GDH-Technologies/cx-clockgen/README.md

# cx-clockgen
Essentially a fork of Rene Wolf's `cxadc-clock-generator-audio-adc` gitlab project
