GDH-Technologies/cx-clockgen/kicad-cx-jig/render-rev-b.png

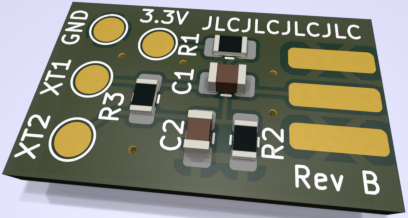
kicad-cx-jig/render-rev-b.png
