GDH-Technologies/cx-clockgen/build-guide/README.md

# Build and installation guide

Ahh so you've come here to build the project, *excellent*!

Before you start ordering and building, you should read the entire guide at least once so you know what to expect.
You will be assembling the project from various ready made components and solder them together.
Most components can be ordered in a finished and populated state, basically you only need to wire them up.
But the two main PCBs of this project need to be ordered with either [JLCPCB][jlcpcb] or [PcbWay][pcbway] and then some SMD parts populated manually.
Don't worry though all SMD parts are rather large 0805, and ordering them with [JLCPCB][jlcpcb] is fast and cheap!
The [hardware](../hardware) section of this project includes the full [KiCad][kicad] project files, so you can also generate gerbers for a different manufacturing house.

If you are new to soldering electronics, learning about it is a bit beyond this guide.
However you may want to start looking here, as these videos cover the things needed for this guide:
- Branchus Creations Beginner's Guide to Soldering Electronics [Part 1](https://www.youtube.com/watch?v=M2Jf8cebwCs) and [Part 2](https://www.youtube.com/watch?v=BPuH1Z2npoQ)
- Electronoobs [SMD Soldering Tutorial | Guide | Tools | Tecniques | Stencil](https://www.youtube.com/watch?v=fYInlAmPnGo)

The steps covered here will assemble the electronic components and flash the firmware on the Raspberry Pi Pico.
Mounting the finished build in your particular PC / setup is beyond the scope of this guide.
You can however have a look in the [mechanical section](../mechanical) for some 3D printable parts that may suit your needs.

This guide will assume you have two PCIe CX based capture cards ready to be modded.
Have a look [over here][vhs-decode-wiki-cxcard] for some sources and options on acquiring those cards.
The instruction in here possibly work with other models, but they were tested and confirmed working with these variants:
- *VT610EX Rev:SC3A VTImage 19.07* capture cards, white pcb, featuring a *CX25800-11Z*

If your board / card variant is not listed here, go over the guide and compare the instructions to your card.
If the parts they are referring to also exist on your board, there's a good chance this guide also works for you.

## General prerequisites

You will be dealing with high frequency digital clock signals.
Even though these are more immune to problems than analog signals, you should have a [Digital storage oscilloscope][wiki-dso] at hand.
You can assemble all of this project without one, but you probably want to check signal integrity, before putting everything together.
In order to correctly assess the signals, your scope should have an analog bandwidth of at least 20MHz, better 100MHz.

You should also have a [Multimeter](https://en.wikipedia.org/wiki/Multimeter#Digital) ready, to test continuity, and verify resistance and possibly capacity.

And finally you will need some basic soldering equipment. 
A fine tip (e.g. 1mm) soldering iron and some good lead-free solder.

Each of the PCBs has a shopping list of components you need to order.
For the SMD parts I always order some spares, in case I make a mistake.
So put add something like 10% additional parts, but at least one extra component per type.

## Ordering PCBs

If you choose a manufacturing house other than [JLCPCB][jlcpcb] or [PcbWay][pcbway], you already know what you need.
The [releases section][releases] of this project holds the finished gerbers for ordering directly from [JLCPCB][jlcpcb] or [PcbWay][pcbway].
When ordering from [JLCPCB][jlcpcb], you should check [these settings (valid as of Sep. 2023)](../hardware/jlc-2023-09-order-example.png) for both boards.
When ordering from [PcbWay][pcbway], you should check [these settings (valid as of Nov. 2023)](../hardware/pcbway-2023-11-order-example.png) for both boards.
The minimum quantity (as of Nov. 2023) is 5 per PCBs (on both manufacturing houses), so for a single clock gen with two [CXADC][cxadc] cards, you will have some spares.

## Building PCB 1 - VT610ex clock generator insert

This PCB adapter will replace the quartz oscillator on a VT610ex PICe capture card.
So you will need to build one these PCBs / adapters per [CXADC][cxadc] card you have.

render

**Shopping list** for *one single* adapter (multiply items by number cards you want to modify):
- 1x PCB "clock-gen-adapter" probably from [JLCPCB][jlcpcb]
- 2x 0805 SMD resistor 1K Ohm, 5% tolerance or better
- 1x 0805 SMD resistor 10K Ohm, 5% tolerance or better
- 1x 0805 SMD capacitor 1.5 nF, 6V or greater, ceramic X5R or X7R
- 1x 0805 SMD capacitor 10 nF, 6V or greater, ceramic X5R or X7R
- Thin wire in 4 colors, AWG 30 (0.25mm) to AWG 20 (0.81mm) works well
- The PCB supports two options for connection to the mainboard
  - Either with pin header / socket and a custom made coax cable
    - 1x 3x2.54mm pin header, straight (it will be mounted "lying / sideways" on the PCB)
    - 1x 3x2.54mm pin socket, straight (it will be soldered as a connector to the coax cable)
    - About 50cm of RG174 coax cable.
      This will be used to connect the adapter to the clock gen mainboard, and the exact length depends on your installation situation.
      You can use a different type of cable here, but the RG174 is still flexible enough to be convenient to handle.
    - Some heat-shrink tube to cover the coax and pin socket
    - Double sided tape to attach the adapter PCB to the back of the CX card
  - Or via SMA edge connectors, which should be paired with another one on the Si5351A sub board
    - 2x Female edge mounting SMA connectors (one for the adapter, and one for the mainboard / Si5351A sub board).
      There are a number of manufacturers that produce these, but they should be about 6-7mm side-to-side, and have a 1.6-1.8 mm PCB clearance, e.g [CON-SMA-EDGE-S](https://mou.sr/3t0dMKq)
    - 1x Male to male SMA cable with a length matching your installation requirements, e.g. [250mm 135101-03-M0.25](https://mou.sr/3Tggbf5)
    - Thick double sided tape to attach the adapter PCB to the back of the CX card.
      Thickness must give enough clearance for the edge mounting SMA connectors, about 2mm should be fine.

First populate the SMD components on the PCB like so:
- R1, R2 as 1K Ohm
- R3 10K Ohm
- C1 1.5 nF
- C2 10 nF

Then solder the 3x pin header sideways onto the edge of the PCB, or solder the edge mounting SMA connector.
Finally solder about 10 cm (4 inches) of wire to each of the pads (XT1, XT2, GND, 3.3V).
Use different colors per pad for easier installation.
You should end up with something like this (pin header shown, not SMA edge connector):

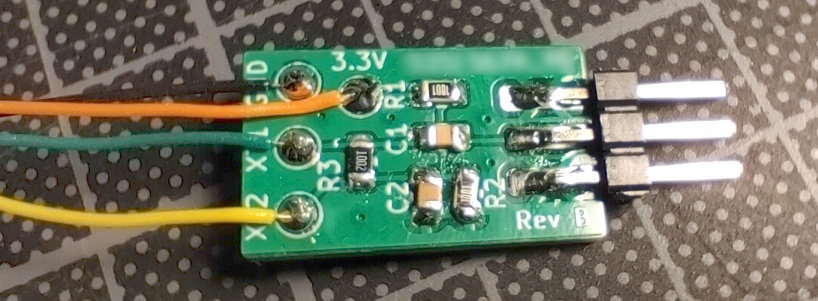
[picture p2: build-guide/adapter-revb-populated.jpg]


If you chose the SMA connector option, this completes the adapter board.

Otherwise you now need to finish the coax cable and connection.
So take the desired length of RG174 coax cable and solder the 3x pin socket to one end.
Remember you can always shorten the cable later, so add some extra length here.
The center pin is the clock signal, the other two pins are shield / ground.
Finally with some heat shrink over it, you should end up with something like this:

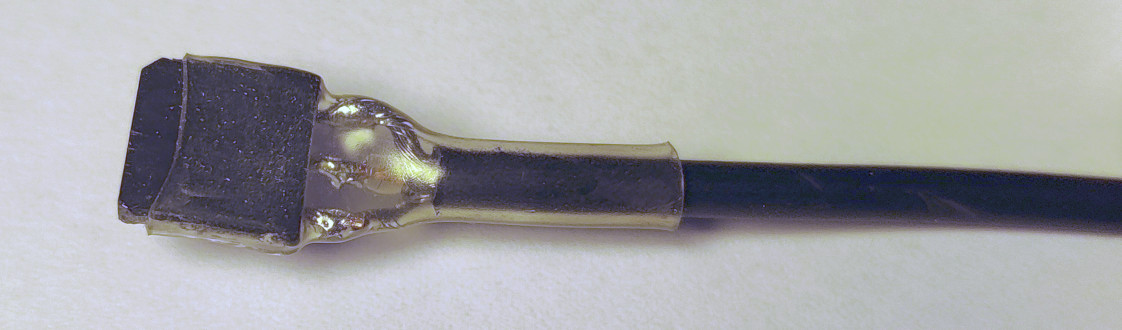
[picture p3: build-guide/adapter-coax-plug.jpg]


This completes the adapter board, so it can be later mounted to a CX card.

## Building PCB 2 - Clock generator and ADC mainboard

This PCB combines a [Raspberry Pi Pico][pi-pico] with a [Adafruit Si5351A Clock Generator Breakout Board][si5351-adafruit], and a [PCM1802 board][pcm1802-product].
The clock generator produces 3 clocks, clock 0 and clock 1 are available for two [CXADC][cxadc] cards, clock 2 drives the [PCM1802 ADC][pcm1802-product].
Optionally a digital input pin can sample the *head switch signal* from your VCR, or any other sync signal you choose.

render

The various sub components can be soldered / mounted on the mainboard, with only pin headers as connection.
However adding pin sockets will enable easy component swapping later, and greatly help with troubleshooting!

**Shopping list mandatory components only** for one mainboard:
- 1x PCB "clock-gen mainboard" probably from [JLCPCB][jlcpcb]
- 1x [Raspberry Pi Pico][pi-pico] (wireless variant can be used, but is not needed, and offers no extra features)
- 1x [Adafruit Si5351A Clock Generator Breakout Board][si5351-adafruit], compatible clones may be found at other places as well.
  If you chose to use SMA edge connectors for the clock lines then the mechanical stress will be taken up by the Si5351A sub board instead of the mainboard PCB.
  Depending on your specific installation, you should add some mechanical support here.
- 1x PCM1802 board, unknown manufacturer but can be [found on aliexpress][ali-pcm1802-search].
- 1x Micro USB cable to connect the Raspberry Pi Pico to your target system.
- 2x 20x2.54mm pin header, straight (mounting the Raspberry Pi Pico)
- 1x 9x2.54mm pin header, straight (mounting the PCM1802 board)
- 1x 7x2.54mm pin header, straight (mounting the Si5351A board)
- About 50cm of shielded, stereo audio cable to connect the PCM1802 stereo inputs to some connector.
  I can recommend [SOMMER Cable SC-Cicada SO-D14](https://shop.sommercable.com/en/Cable/Bulk-Cable-Audio/Patch-Mikrofonkabel-SC-Cicada-SO-D14-200-0451.html) or the [Belden 8451](https://www.belden.com/products/cable/audio-cable/analog-audio-cable/8451).
  The exact length depends on your installation situation.
- 2x RCA socket for stereo analog input.
  Feel free to choose a different connection type for your setup.
  This build guide will skip over this part, and it is listed here only to remind you to include this in your shopping spree.

**Shopping list optional components** for one mainboard, in addition to the list above:
- 2x Heat sinks for the CX chips, with adhesive thermal pads to mount.
  As the clock generator will deliver higher clock frequencies than the stock crystal, the chips will get warmer.
- 2x 20x2.54mm pin socket, straight (making the Raspberry Pi Pico removable again)
- 1x 9x2.54mm pin socket, straight (making the PCM1802 board removable again)
- 1x 7x2.54mm pin socket, straight (making the Si5351A board removable again)
- 1x 0805 SMD capacitor 10 µF, 6V or greater, ceramic X5R or X7R.
  This can be used to further decuple the 5V analog rail on the PCM1802 chip.
  It is unlikely you will need this unless your USB 5V supply is quite bad.
  But then you probably should not be using the system to capture analog RF signals either ...

**Shopping list for optional head switch signal input** for one mainboard, in addition to the lists above (can be left entirely unpopulated if you don't need that):
- 1x 0805 SMD resistor 1K Ohm, 5% tolerance or better.
- 1x 3.3V Zener diode either SMD SOD-123 package or through hole
- 1x regular signal diode either SMD SOD-123 package or through hole
- 1x 2x2.54mm pin header, straight (serves as a connection point on the PCB for the signal input).
- 1x 2x2.54mm pin socket, straight (serves as a connector plug).
- About 50cm of shielded, cable for the head switch signal.
  This signal is rather low frequency and digital, so most cables should work.
  You can just use the same shielded (stereo) audio cable from the PCM1802 connection.
  The exact length depends on your installation situation.
- 1x RCA socket for head switch signal input.
  Feel free to choose a different connection type for your setup, e.g. BNC, SMA, what ever works for you.
  This build guide will skip over this part, and it is listed here only to remind you to include this in your shopping spree.

First we need to configure the PCM1802 board, and fix a design bug on it.
The under side of the board has a couple of solder bridges to configure the PCM1802, and we want to bridge both `MODE0` and `MODE1`.
However this board (at least the ones I bought in 2022), have a bug: the `+` side of the solder bridges is *not* connected to 3.3V.
You can confirm with your Multimeter, there is no continuity between the `+` connections and the 3.3V terminal.
This can be easily fixed with an additional bodge wire from the bottom to the top side.
Make sure to install the pin header first, then run the bodge like so:

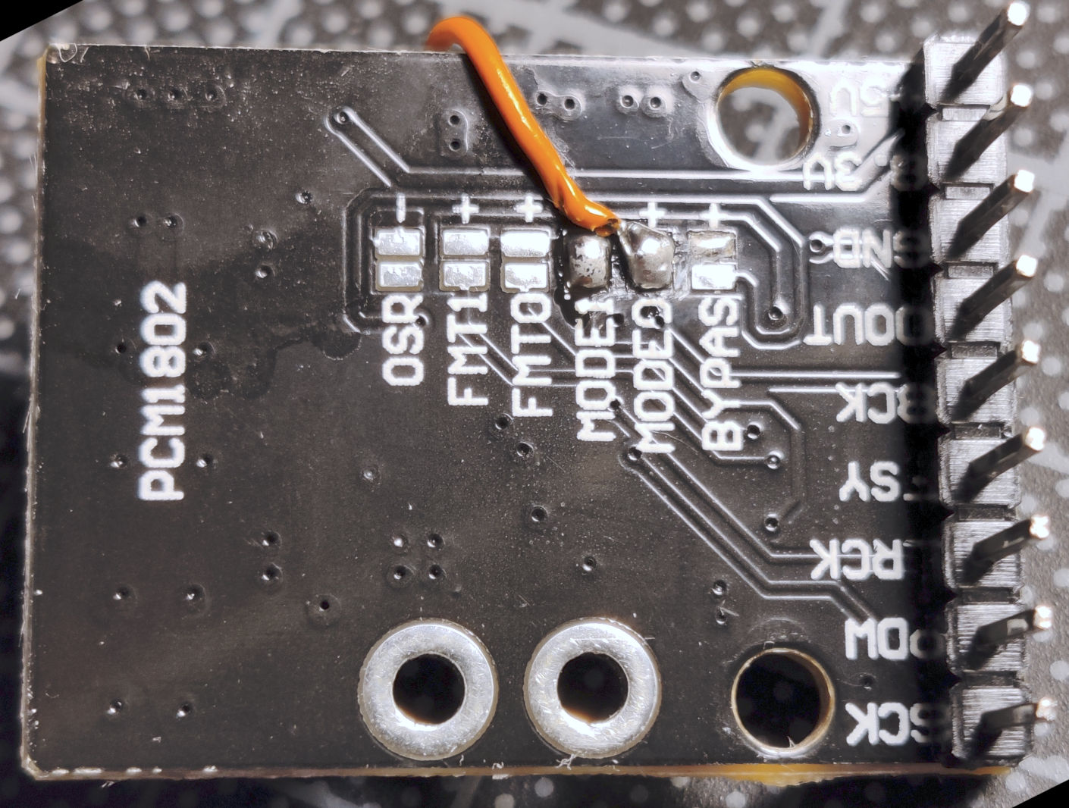
[picture p4: build-guide/pcm1802-back.jpg]


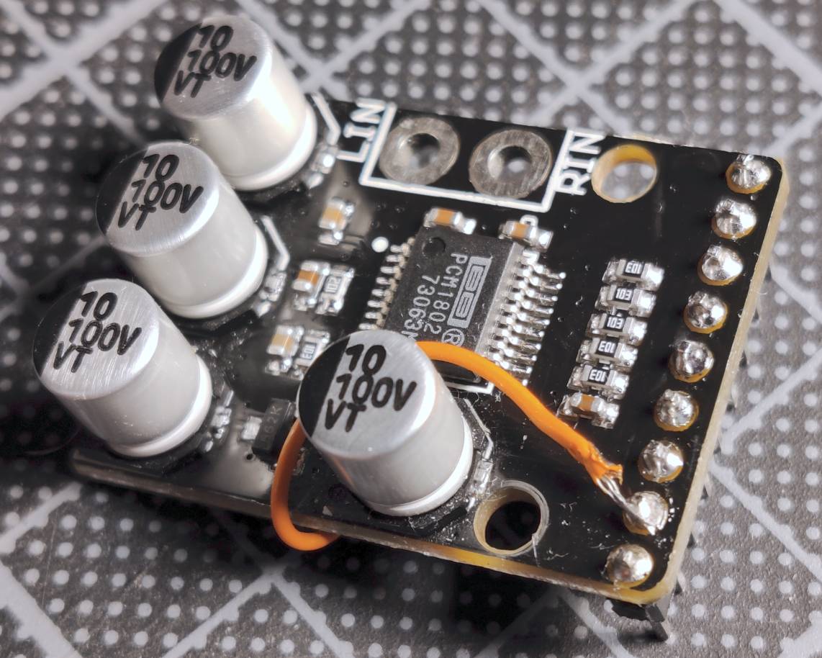
[picture p5: build-guide/pcm1802-front.jpg]


Next populated the remaining pin headers, and optionally sockets, on the mainboard, Raspberry Pi and Si5351A.
The Si5351A board may have come with SMA edge connectors, which can be used to connect the clock lines to the adapter boards (check that they are the opposite of your male cables).
So if you chose to use SMA edge connectors, then instead of later soldering the coax directly to the mainboard, you can populate and use those.

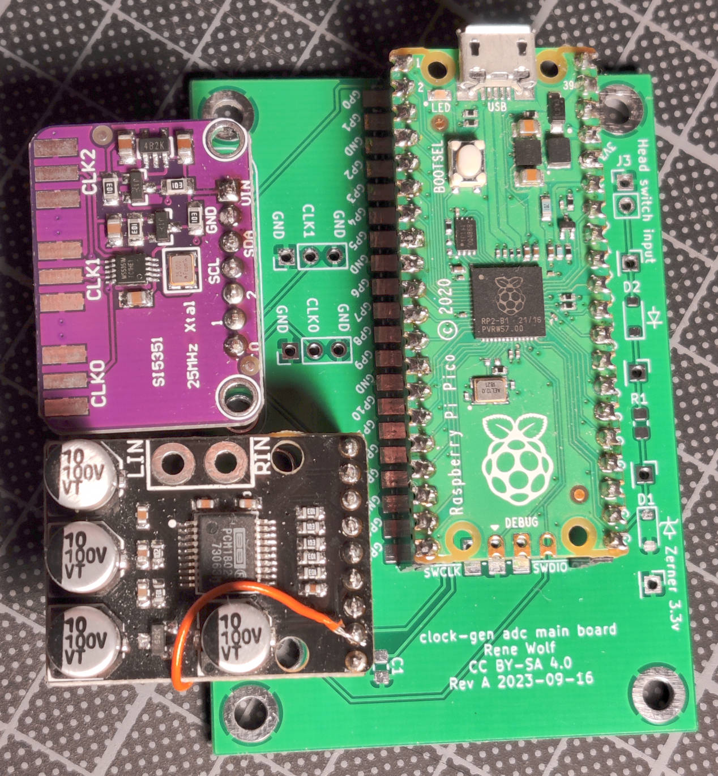
[picture p6: build-guide/mainboard-assembled.jpg]


Solder the stereo audio cable to the PCM1802 L and R inputs.
Finally solder your RG174 coax cables to the clock outputs 0 and 1 on the mainboard, or populate the SMA edge connectors on clock 0 and 1 of the Si5351A sub board.
This completes the mandatory part, and you can move on to the next section.

Optionally you can populate C1 with the 10 µF cap.

Optionally if you want the head switch input, you need to populate some additional things:
- R1 with 1K Ohm
- D1 with the 3.3V zener diode (observe polarity as per markings on the PCB)
- D2 with the regular switching diode (observe polarity as per markings on the PCB)
- J3 with the pin header for connection
- any additional work for cabling this up, as per your setup needs

## Installation

This section deals with the overall installation of the previously build components.
The firmware section is common to all card variants, but the adapter PCB install may differ.
So after installing the firmware, skip over to what ever section matches your CX card variant.

### Installation - firmware

By now you can flash the firmware to the Raspberry Pi and test whether its clock outputs are working.
Download the firmware zip file from the [releases][releases] page, and get your [Digital storage oscilloscope][wiki-dso] ready.

Do not connect the adapter boards yet, just leave the coax cable unconnected.
Locate the *.uf2* file in the zip and [flash it to the Raspberry Pi Pico](https://www.okdo.com/getting-started/get-started-with-raspberry-pi-pico/).
This will automatically restart the Pico and it will register as a UAC audio device.
The LED on the Pico should be be flashing regularly (about once every second).

Check `dmesg` to see this:

```dmesg
[121467.020996] usb 1-1: new full-speed USB device number 7 using xhci_hcd
[121467.171072] usb 1-1: New USB device found, idVendor=1209, idProduct=0001, bcdDevice= 1.00
[121467.171084] usb 1-1: New USB device strings: Mfr=1, Product=2, SerialNumber=3
[121467.171090] usb 1-1: Product: CXADC+ADC-ClockGen
[121467.171095] usb 1-1: Manufacturer: Rene Wolf
[121467.171099] usb 1-1: SerialNumber: XXXXXXXXXXXXXXXX
```

And `arecord -L` should include this:

```
hw:CARD=CXADCADCClockGe,DEV=0
    CXADC+ADC-ClockGen, USB Audio
    Direct hardware device without any conversions
```

Your Pico is now setup, and next we'll check the clock outputs.
Locate the pins labeled *0,1,2* on the Si5351A pin header, each corresponds to one clock signal output.
With your scope check that the following default frequencies are generated:
- Clock 0 - 28.6 MHz
- Clock 1 - 28.6 MHz
- Clock 2 - 12.288 MHz

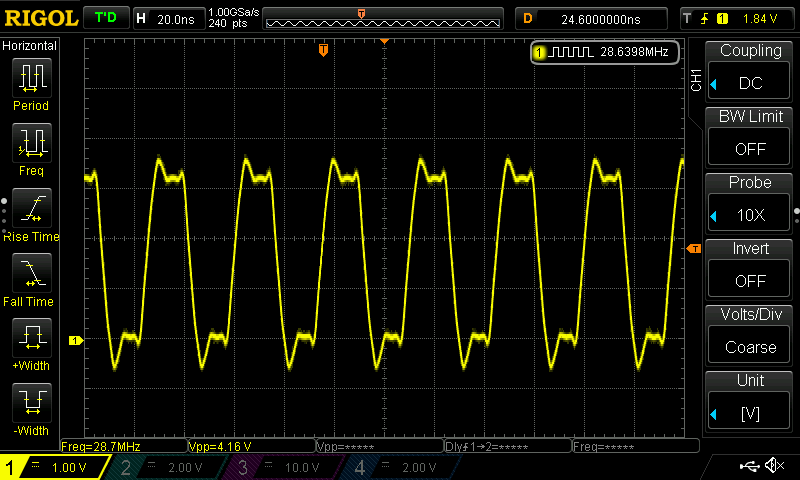
[picture p7: build-guide/clock0-28.6mhz-ok.png]


The image above show how the 28.6 MHz output on clock 0 should look.
If all the clock outputs look reasonable, this concludes the firmware installation.
You can move on to prepare the CX cards.

### Installation - adapter - *VT610EX Rev:SC3A VTImage 19.07* card

The following steps will remove the onboard quartz clock source and add the adapter board to hook up the clock gen.
Beware that a CX card without a clock source will prevent a PC from booting!
So after you removed the components you need to have an external clock source on your card if its plugged into your PC.

This card has 4 components that need to be removed: Y1 (crystal), C22, C19, R12.
The following image shows them marked in pink:

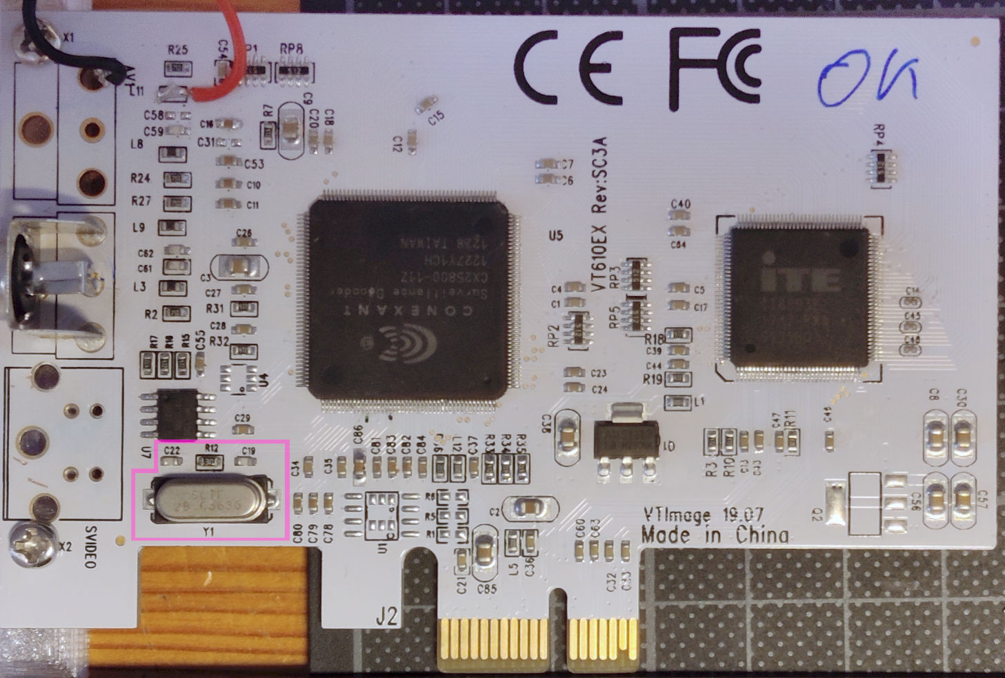
[picture p8: build-guide/vt610ex-to-be-removed.jpg]


With the components removed, turn the card around and using double sided tape attach the adapter PCB like so:

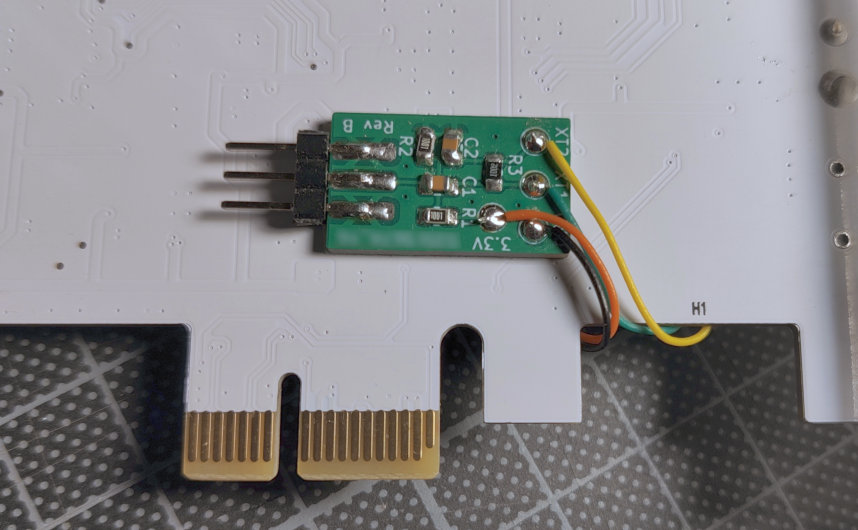
[picture p9: build-guide/adapter-revb-card-backside.jpg]


Turn the card to the front again, and solder the 4 wires from the adapter board.
3.3V and GND can be tapped from C85, XT1 and XT2 are the two pads of the crystal.
The following image shows the finished mod, the hand written *1* and *2* denote the *XT1* and *XT2* lines, and the previously removed and now unpopulated components marked in pink once more:

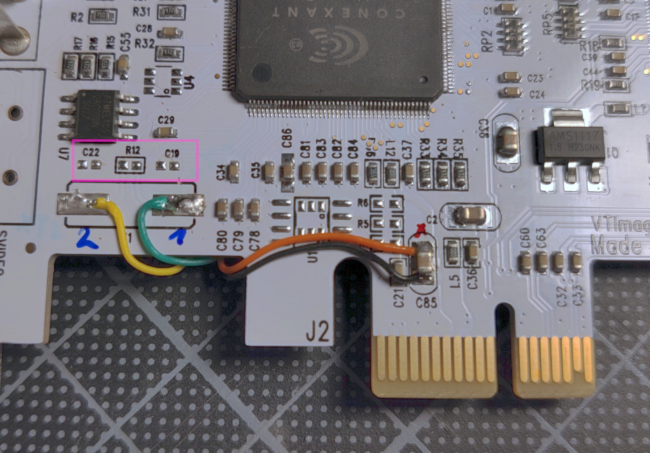
[picture p10: build-guide/adapter-revb-card-frontside.jpg]


This completes the adapter board installation.

### Installation - finished setup

When you are finished with your CX card(s), you are pretty much done.
Here's how this looks with one card attached to the clock gen mainboard:

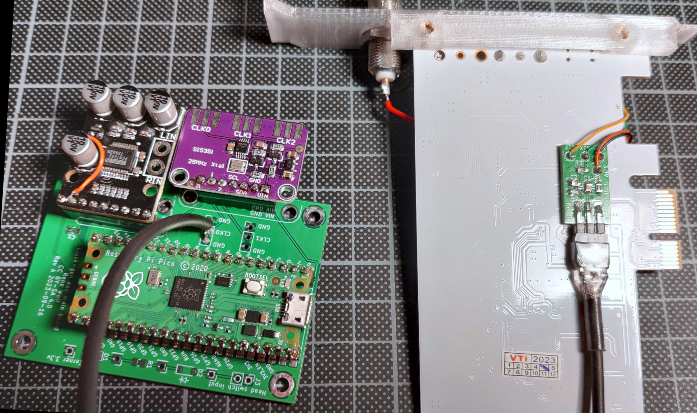
[picture p11: build-guide/mainboard-adapter-card.jpg]


NOTE this image misses the audio cable, and has the optional head switch input unpopulated.

You can now install the CX cards and the clock gen into your PC.
Also install any additional connection (e.g. audio and head switch RCA plugs) and wire them up as per your liking.
After booting your PC, all CX cards should show up as usual, and capturing should work as normal.
Using `alsamixer` (press F6 to choose your card) you can now switch clock rates on both cards.
To test PCM1802 audio ADC capture, you can run `arecord -D hw:CARD=CXADCADCClockGe -c 3 -r 48000 -f S24_3LE out.wav`.

That's it you are ready for some sync RF capture!

## Troubleshooting

As with any complex system, you may encounter problems.
The information in this section should help to find the cause for common problems when assembling the setup.
Be aware that troubleshooting and debugging is also an art and improves with experience.
So the guide and advise here can never catch all cases and you are encouraged to think about the steps you take.

Notes:
- Any commands shown are *case sensitive* so make sure to type them exactly as show here
- The screw terminals on the mainboard are GND
- The guide assumes you did check GND for continuity across all sub boards and to the USB connector
- Have the Raspberry Pi Pico [pinout](https://www.raspberrypi.com/documentation/microcontrollers/raspberry-pi-pico.html) at hand for referencing pin locations

With that out of the way, start by following the path in this diagram, details on relevant step are explained further down.
Don't be intimidated by the size, just follow the arrows, start on the left :grin:.

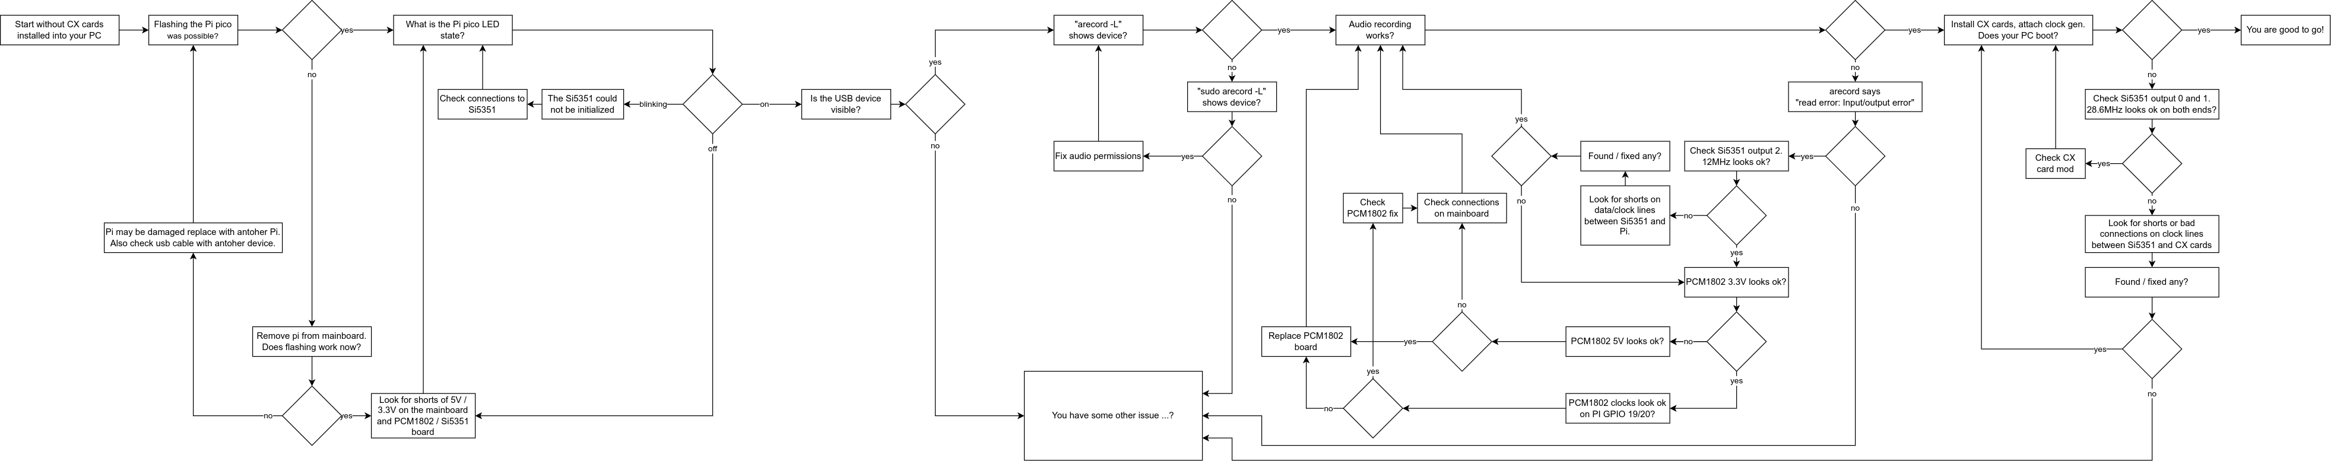
[picture p12: build-guide/troubleshoot-decisions.png]


If the diagram leads you in a loop then you may have a problem that is not covered here.
You can look at the ["Other issues"][self-other-issue] section.

### Flashing the Pi pico

The Pi pico has a boot loader that cannot be overwritten.
Have a look [here](https://www.okdo.com/getting-started/get-started-with-raspberry-pi-pico/) on how to flash it.
You can download the mentioned [blink.uf2](https://datasheets.raspberrypi.com/soft/blink.uf2) example to check whether your Pi device is generally working.
If you flashed the blink test, make sure to re-flash the clock gen firmware.
The guide will generally assume you have the clock gen firmware installed.

### What is the Pi pico LED state?

Since firmware version 1.1.0, after booting the LED can have 3 states:
- off: early boot stage failed or power is not good
- blinking at about 2 Hz: the Si5351 clock generator could not be found
- on: booting finished normally

### Look for shorts of 5V / 3.3V on the mainboard and PCM1802 / Si5351 board

The following needs a multimeter. 
Unplug all subboards from the mainboard, and test individually, then combined:
- confirm no continuity between the 5V and GND on the PCM1802 board and mainboard.
- confirm no continuity between the 5V / VBus on the Pi and GND.
- confirm no continuity between the 3.3V / Vin and GND on the Si5351 board and mainboard.
- confirm continuity on 5V / VBus across all boards.
- confirm continuity on GND across all boards.

Note both the PCM1802 and Si5351 have passive and active component on them.
This will cause a reading of a couple 100k Ohms from any of 3.3V/5V pins to GND on the boards.
This is normal and only if your reading is below about 1000 / 1k Ohms it should be counted as a short.

### Check connections to Si5351

The following needs a multimeter.
- confirm no continuity between the Vin and GND on the Si5351 board.
- confirm no continuity between the 3.3V on the Pi and GND.
- confirm continuity on 3.3V, GND, SDA, SCL from Pi to Si5351 board.

### Is the USB device visible?

This tells you whether the USB enumeration (when a USB host discovers a USB device) was successful.
Run `lsusb` as a normal user, check if the output contains this line:

```
Bus 002 Device 003: ID 1209:0001 Generic pid.codes Test PID
```

If yes, it means the host can talk to the clock gen.
If no, then the USB communication is not working, either due to an electrical problem on the connection, or a non-working firmware on the Pi pico.

### Look for shorts on the mainboard

The following needs a multimeter, and both the PCM1802 and Si5351 board unplugged from the mainboard.
- confirm no continuity between the GND plane and any of the power pins on the Pi pico, PCM1802 and Si5351 connectors.

Remove any shorts / solder bridges you find.

### `arecord -L` / `sudo arecord -L` shows device?

This tells you whether the ALSA sound system correctly detected the clock gen as a sound card.
Run `arecord -L` as a normal user, check if the output contains these lines:

```
hw:CARD=CXADCADCClockGe,DEV=0
    CXADC+ADC-ClockGen, USB Audio
    Direct hardware device without any conversions
```

If they show up, everything is fine, if not retry with `sudo arecord -L`.
If they show up now, it means your normal user misses the permissions to do audio capture.
If they still don't show up, its another problem, that is not covered here.

### Fix audio permissions

This depends on the linux distribution you have.
Under debian / ubuntu based OS, your user needs to be in the `audio` group to be able to capture or play audio.
So add your user to the `audio` group, [see these steps](https://askubuntu.com/questions/79565/how-to-add-existing-user-to-an-existing-group).

### Audio recording works?

Run the following command:

```bash
arecord -D hw:CARD=CXADCADCClockGe -c 3 -r 46875 -f S24_3LE --samples=1000 test.wav
```

It should respond with only the following and produce a file called `test.wav` that is around 9kb in size.

```
Recording WAVE 'test.wav' : Signed 24 bit Little Endian in 3bytes, Rate 46875 Hz, Channels 3
```

If the outputs includes something like the following, then recording did not work as expected.

```
arecord: pcm_read:2221: read error: Input/output error
```

The above generic "read error: Input/output error" error can have multiple reasons.
But it is a good indication that no data is coming from the PCM1802 sub board to the Pi.

Since firmware version 1.1.0 the audio output can be switch to a debug mode.
Open `alsamixer`, select the clock gen sound card (F6), select the capture controls (F4), and mute "Audio Control" by pressing the *space bar*.
When muted the text "CAPTURE" should be replaced with "---------".
Retry the above `arecord` command, if it is successful, then there is a problem with the data from the PCM1802 subboard.
The wav file contains a dump of the content of the global status structure found in [global_status.h][code-status].
This may be able to tell you which lines are affected (LRCK/BCK/DATA).

### Check Si5351 output 0/1/2

The following check needs a [DSO][wiki-dso].
You may be able to use a multimeter if it has a frequency counter that goes high enough.
See ["Installation - firmware"][self-clk-wave] for expected wave form and frequency per output.
If outputs 0 and/or 1 are connected to the adapter board, check the clock signal on both ends (mainboard and adapter board).

### Look for shorts on data/clock lines between Si5351 and Pi.

The following needs a multimeter, both Pi and Si5351 must be plugged onto the mainboard.
Check continuity on the SCL and SDA lines from Si5351 to Pi.
Check no continuity on the SCL and SDA lines to GND or 3.3V.
Beware that the SCL and SDA lines have pull-ups, of a couple kOhms, so only a very low resistance (less than 10 Ohms) should be counted as short.

### PCM1802 3.3V / 5V looks ok?

The following needs a multimeter, both Pi and PCM1802 must be plugged onto the mainboard. 
The PCM1802 board has an onboard regulator that converts the 5V from the USB (VBus on Pi) down to 3.3V.
Both the converted 3.3V and 5V are available on the PCM1802 pin header.
While clock gen is powered up, check those voltages to GND.

### PCM1802 clocks look ok on PI GPIO 19/20?

The following check needs a [DSO][wiki-dso].
You may be able to use a multimeter if it has a frequency counter that goes high enough.
- The LR clock pin ("LRCK") from the PCM1802 is connected to GPIO 20 in the PI.
  Check that this carries a 48kHz or 46kHz clock signal.
  Verify both ends.
- The Bit clock pin ("BCK") from the PCM1802 is connected to GPIO 19 in the PI.
  Check that this carries an about 3MHz clock signal.
  Verify both ends.

If the clocks are absent or heavily distorted, look for shorts / bridges on the PCM1802 pin header.

Since firmware version 1.1.0 the audio output can be switch to a debug mode.
Executing the [info collection script][scripts] will do that (debug.wav).
This will dump the content of the global status structure found in [global_status.h][code-status].
It contains flags that indicate activity on the three PCM1802 lines, which could help to find the problematic connection.

### Check PCM1802 fix

The following needs a multimeter, the PCM1802 board can optionally be removed from the mainboard.
Make sure both bridges `MODE0` and `MODE1` on the underside of PCM1802, are closed and connected to 3.3V.
See above build guide for images and more details.

### Check CX card mod

Under good light conditions, recheck that:
- all the components were removed correctly 
- no solder bridge remains
- the wiring is correct

See above build guide for images and more details.

### You have some other issue ...?

As said initially this guide cannot cover all possible combinations of problems.
But you could:
- retry the debugging / troubleshooting steps to make sure you didn't over look something
- use a different PC and/or USB port
  - do not use a USB hub those can cause issues
  - if you use a USB3 port, try a USB2 port
- use a different [revision of the clock gen firmware][releases]
- use the [info collection script][scripts] and ask for help on the domesday discord server (see instructions [here][discord])

[jlcpcb]: https://jlcpcb.com
[pcbway]: https://www.pcbway.com
[pcm1802-product]: https://www.ti.com/product/PCM1802
[ali-pcm1802-search]: https://www.aliexpress.com/w/wholesale-PCM1802.html?SearchText=PCM1802
[pi-pico]: https://www.raspberrypi.com/products/raspberry-pi-pico/
[si5351-adafruit]: https://www.adafruit.com/product/2045
[cxadc]: https://github.com/happycube/cxadc-linux3/
[kicad]: https://www.kicad.org/
[vhs-decode-wiki-cxcard]: https://github.com/oyvindln/vhs-decode/wiki/CX-Cards
[releases]: https://gitlab.com/wolfre/cxadc-clock-generator-audio-adc/-/releases
[wiki-dso]: https://en.wikipedia.org/wiki/Digital_storage_oscilloscope
[scripts]: ../scripts
[discord]: https://github.com/happycube/ld-decode
[self-clk-wave]: #installation-firmware
[self-other-issue]: #you-have-some-other-issue-
[code-status]: ../firmware/src/global_status.h
