GDH-Technologies/cx-clockgen/kicad-cx-jig/clockgen-cx-jig.kicad_pcb

## KiCad design kicad-cx-jig/clockgen-cx-jig.kicad_pcb (2026-06-12)

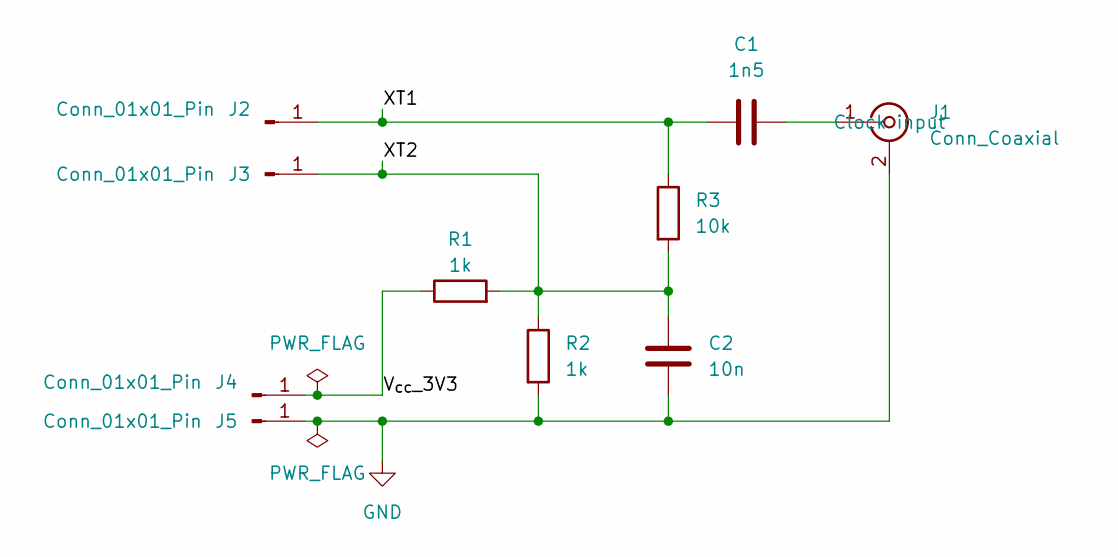
[picture p13: schematic clockgen-cx-jig.kicad_sch, ${proj-title}]

Parts:
C1: 1n5; C_0805_2012Metric_Pad1.18x1.45mm_HandSolder
C2: 10n; C_0805_2012Metric_Pad1.18x1.45mm_HandSolder
J1: Conn_Coaxial; SMA_Samtec_SMA-J-P-H-ST-EM1_EdgeMount
J2, J3, J4, J5: Conn_01x01_Pin; TestPoint_Pad_D2.0mm
R1, R2: 1k; R_0805_2012Metric_Pad1.20x1.40mm_HandSolder
R3: 10k; R_0805_2012Metric_Pad1.20x1.40mm_HandSolder

Connections:
/V_{cc}_3V3: J4.1 (Pin_1_1), R1.1
/XT1: C1.2, J2.1 (Pin_1_1), R3.1
/XT2: C2.1, J3.1 (Pin_1_1), R1.2, R2.1, R3.2
GND: C2.2, J1.2 (Ext), J5.1 (Pin_1_1), R2.2
unnamed: C1.1, J1.1 (In)

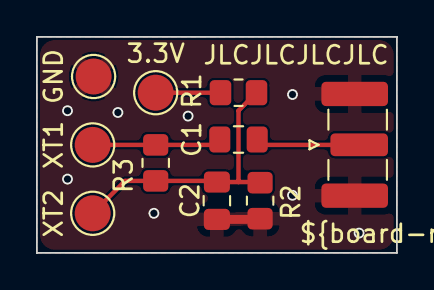
[picture p14: board clockgen-cx-jig.kicad_pcb from above]

Board: 2 copper layers, 20.0 x 12.0 mm, 11 parts (0 on the bottom side), 5 nets.

Other parts of the board:
${board-ref}**: Board
