GDH-Technologies/cx-clockgen/kicad-clockgen-main-board/clockgen-main-board.kicad_pcb

## KiCad design kicad-clockgen-main-board/clockgen-main-board.kicad_pcb (2026-06-12)

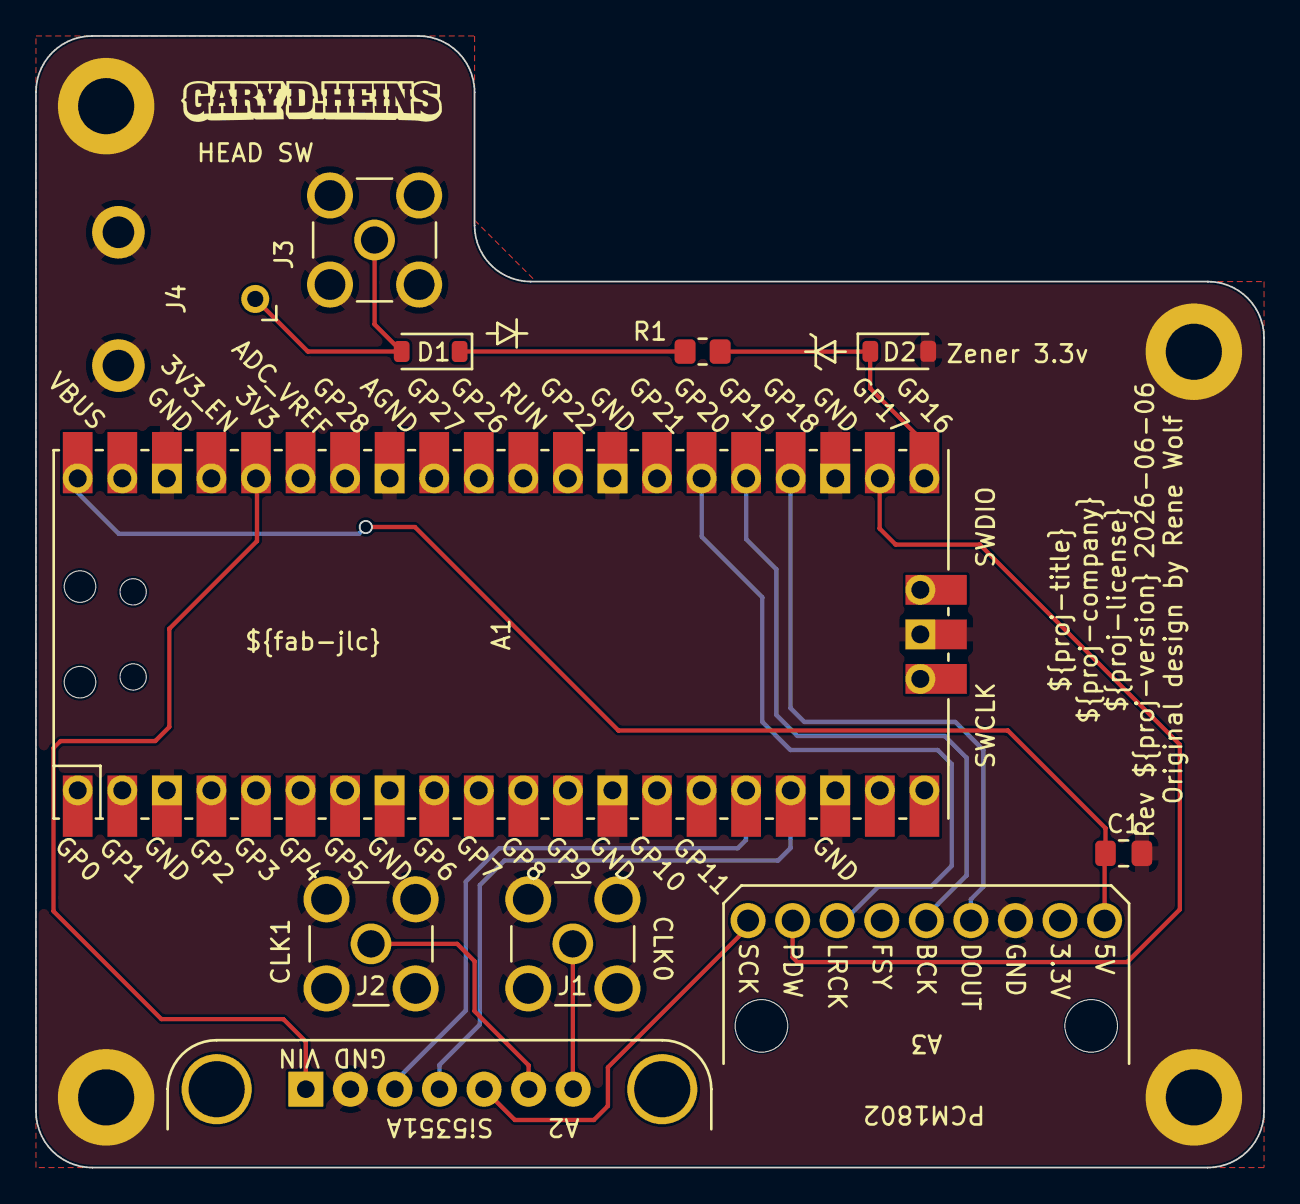
[picture p15: board clockgen-main-board.kicad_pcb from above]

Board: 2 copper layers, 70.0 x 64.5 mm, 16 parts (0 on the bottom side), 15 nets.

Parts:
${board-ref}**: Board
A1: Pico; Pi_Pico_SMD_TH
A2: Si5351A; Adafruit_Si5351A_Breakout_Board
A3: PCM1802; black-pcm1802-board
C1: 10u; C_0805_2012Metric_Pad1.18x1.45mm_HandSolder
D1: D; D_SOD-123
D2: D_Zener; D_SOD-123
H1, H2, H3, H4: MountingHole_Pad; MountingHole_3.2mm_M3_ISO14580_Pad
J1: CLK0_SMA; GRADCONN_RFPC-SMA28-F
J2: CLK1_SMA; GRADCONN_RFPC-SMA28-F
J3: Headswitch_SMA; GRADCONN_RFPC-SMA28-F
J4: Headswitch_BNC; Molex_0731000154_BNC_RA_THT
R1: 1k; R_0805_2012Metric_Pad1.20x1.40mm_HandSolder

Connections:
/Gen.SCL: A1.17 (GPIO13), A2.3 (SCL)
/Gen.SDA: A1.16 (GPIO12), A2.4 (SDA)
/Gen.VSI: A1.36 (3V3), A2.6 (VIN)
/Head_SW_In: D1.2 (A), J3.1, J4.1 (In)
/PCM.5V: A1.40 (VBUS), A3.1 (+5V), C1.1
/PCM.BitClk: A1.25 (GPIO19), A3.5 (BCK)
/PCM.Data: A1.24 (GPIO18), A3.4 (DOUT)
/PCM.LRClk: A1.26 (GPIO20), A3.7 (LRCK)
/PCM.PwrDn: A1.22 (GPIO17), A3.8 (PDW)
/PCM.SysClk: A2.2 (CLK2), A3.9 (SCK)
GND: A1.3 (GND), A1.8 (GND), A1.13 (GND), A1.18 (GND), A1.23 (GND), A1.28 (GND), A1.33 (AGND), A1.38 (GND), A1.42 (GND), A2.5 (GND), A3.3 (GND), C1.2, D2.2 (A), H1.1 (1_1), H2.1 (1_1), H3.1 (1_1), H4.1 (1_1), J1.2 (GND_2), J2.2 (GND_2), J3.2 (GND_2), J4.2 (Ext)
unnamed: A1.21 (GPIO16), D2.1 (K), R1.2
unnamed: A2.0 (CLK0), J1.1
unnamed: A2.1 (CLK1), J2.1
unnamed: D1.1 (K), R1.1
