GDH-Technologies/cx-clockgen/hardware/cx-clockgen-mainboard-kicad/cxadc-clockgen.kicad_pcb

## KiCad design hardware/cx-clockgen-mainboard-kicad/cxadc-clockgen.kicad_pcb (2026-06-06)

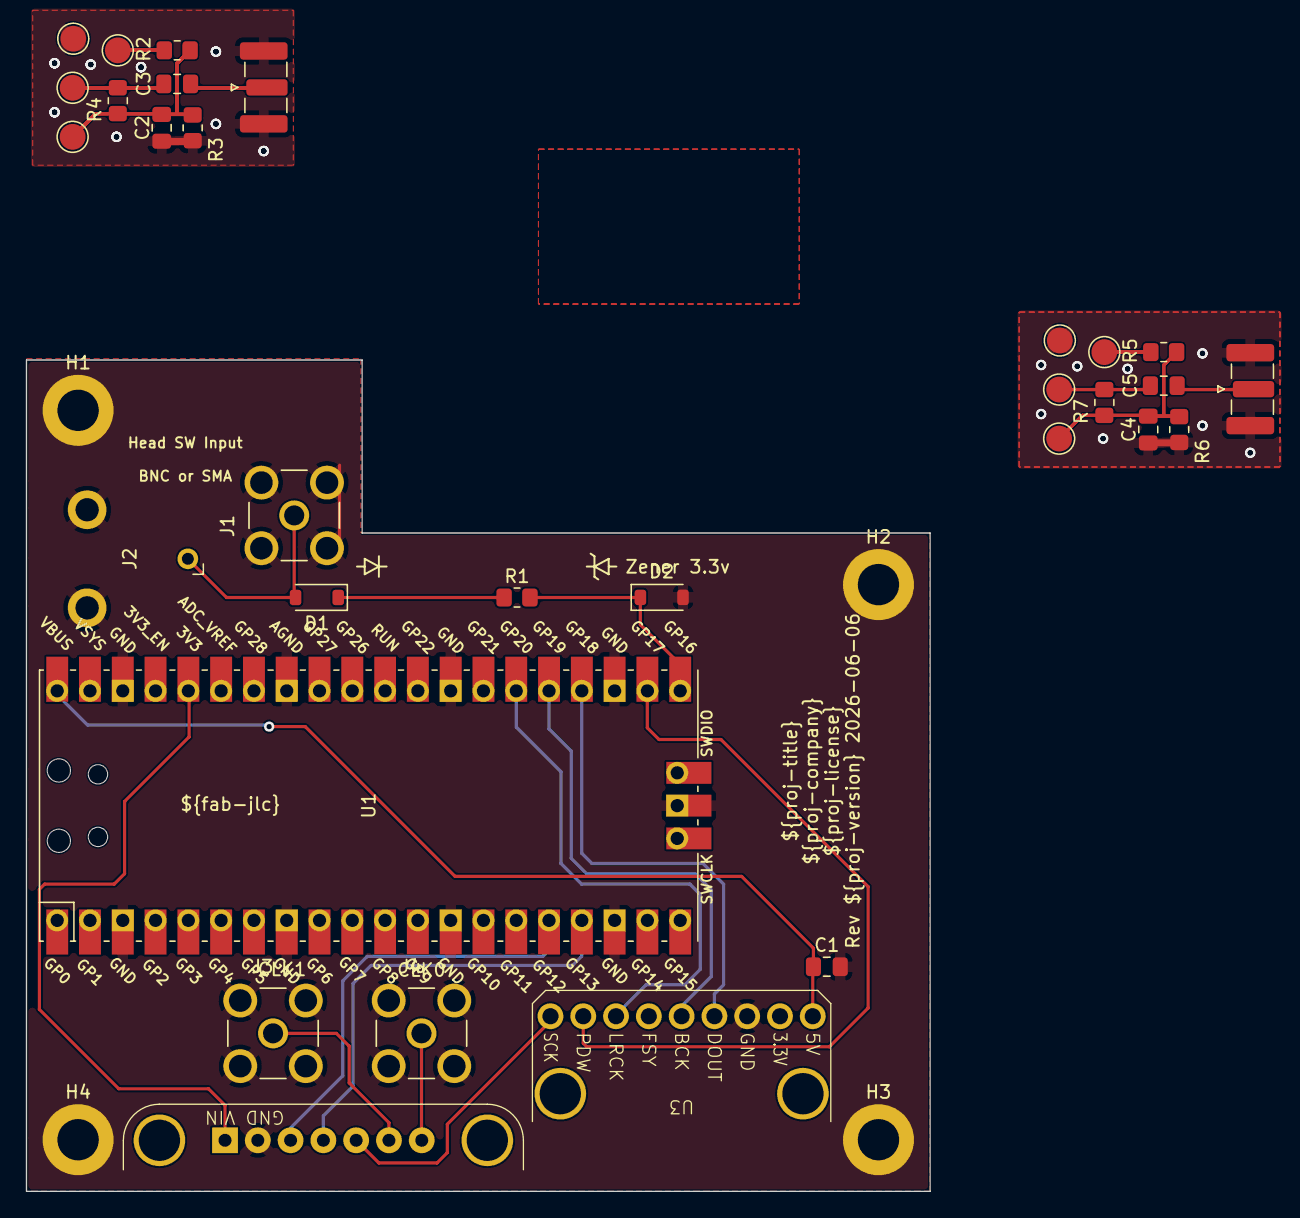
[picture p16: board cxadc-clockgen.kicad_pcb from above]

Board: 2 copper layers, 70.0 x 64.4 mm, 35 parts (0 on the bottom side), 23 nets.

Parts:
C1: 10u; C_0805_2012Metric_Pad1.18x1.45mm_HandSolder
C2, C4: 10n; C_0805_2012Metric_Pad1.18x1.45mm_HandSolder
C3, C5: 1n5; C_0805_2012Metric_Pad1.18x1.45mm_HandSolder
D1: D; D_SOD-123
D2: D_Zener; D_SOD-123
H1, H2, H3, H4: MountingHole_Pad; MountingHole_3.2mm_M3_ISO14580_Pad
J1: Headswitch_SMA; GRADCONN_RFPC-SMA28-F
J2: Conn_Coaxial; Molex_0731000154_BNC_RA_THT
J3, J4: Conn_01x03_Pin; GRADCONN_RFPC-SMA28-F
J5, J6, J7, J8, J10, J11, J12, J13: Conn_01x01_Pin; TestPoint_Pad_D2.0mm
J9, J14: Conn_Coaxial; SMA_Samtec_SMA-J-P-H-ST-EM1_EdgeMount
R1, R2, R3, R5, R6: 1k; R_0805_2012Metric_Pad1.20x1.40mm_HandSolder
R4, R7: 10k; R_0805_2012Metric_Pad1.20x1.40mm_HandSolder
U1: Pico; Pi_Pico_SMD_TH
U2: Adafruit_Si5351A_Breakout_Board
U3: black-pcm1802-board

Connections:
/HiFi Audio CX Jig/V_{cc}_3V3: J5.1 (Pin_1_1), R2.1
/HiFi Audio CX Jig/XT1: C3.2, J7.1 (Pin_1_1), R4.1
/HiFi Audio CX Jig/XT2: C2.1, J8.1 (Pin_1_1), R2.2, R3.1, R4.2
/Main Board/Gen.SCL: U1.17 (GPIO13), U2.3 (SCL)
/Main Board/Gen.SDA: U1.16 (GPIO12), U2.4 (SDA)
/Main Board/Gen.VSI: U1.36 (3V3), U2.6 (VIN)
/Main Board/Head_SW_In: D1.2 (A), J1.1, J2.1 (In)
/Main Board/PCM.5V: C1.1, U1.40 (VBUS), U3.1 (+5V)
/Main Board/PCM.BitClk: U1.25 (GPIO19), U3.5 (BCK)
/Main Board/PCM.Data: U1.24 (GPIO18), U3.4 (DOUT)
/Main Board/PCM.LRClk: U1.26 (GPIO20), U3.7 (LRCK)
/Main Board/PCM.PwrDn: U1.22 (GPIO17), U3.8 (PDW)
/Main Board/PCM.SysClk: U2.2 (CLK2), U3.9 (SCK)
/Video CX Jig/V_{cc}_3V3: J10.1 (Pin_1_1), R5.1
/Video CX Jig/XT1: C5.2, J12.1 (Pin_1_1), R7.1
/Video CX Jig/XT2: C4.1, J13.1 (Pin_1_1), R5.2, R6.1, R7.2
GND: C1.2, C2.2, C4.2, D2.2 (A), H1.1 (1_1), H2.1 (1_1), H3.1 (1_1), H4.1 (1_1), J1.2 (GND_2), J2.2 (Ext), J3.2 (GND_2), J4.2 (GND_2), J6.1 (Pin_1_1), J9.2 (Ext), J11.1 (Pin_1_1), J14.2 (Ext), R3.2, R6.2, U1.3 (GND), U1.8 (GND), U1.13 (GND), U1.18 (GND), U1.23 (GND), U1.28 (GND), U1.33 (AGND), U1.38 (GND), U1.42 (GND), U2.5 (GND), U3.3 (GND)
unnamed: D1.1 (K), R1.1
unnamed: D2.1 (K), R1.2, U1.21 (GPIO16)
unnamed: C3.1, J9.1 (In)
unnamed: C5.1, J14.1 (In)
unnamed: J4.1, U2.0 (CLK0)
unnamed: J3.1, U2.1 (CLK1)
