GDH-Technologies/cx-clockgen/(commit log)

2026-04-28 Added main board and cx jig kicard projects
    [adafruit-si5351-breakout.FCStd, black-pcm1802-breakout.FCStd, clock-gen-main-board.kicad_pcb, clock-gen-main-board.kicad_sch, cx_jig.kicad_sch, vt610ex-sc3a-clock-gen-adapter.kicad_pcb, vt610ex-sc3a-clock-gen-adapter.kicad_sch]
2026-04-28 Added missing folders
    [adafruit-si5351-breakout.FCStd, black-pcm1802-breakout.FCStd, clock-gen-main-board.kicad_pcb, clock-gen-main-board.kicad_sch, cx_jig.kicad_sch]
2026-04-28 Added missing setup shell scripts
    [clock-gen-main-board.kicad_pcb, clock-gen-main-board.kicad_sch, cx_jig.kicad_sch]
2026-05-10 Updated build and installation scripts for improved functionality and error handling; added new package installation logic for Debian and Fedora, enhanced logging, and refined project settings in KiC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
    [clock-gen-main-board.kicad_sch, vt610ex-sc3a-clock-gen-adapter.kicad_pcb]
2026-06-05 Updated KiCad project files to version 20260206, improved tenting and covering settings, and added new parameters for zone clearance. Modified footprint and net definitions for better clarity. Enhanc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
    [clock-gen-main-board.kicad_pcb]
2026-06-05 Updated KiCad project files: set schematic revision to project version, changed pin-to-pin error handling, updated UUID, and modified component properties for better visibility and placement control.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
    [vt610ex-sc3a-clock-gen-adapter.kicad_sch]
2026-06-06 Remove obsolete KiCad library files, including symbol, footprint, and 3D model files for ADA4857-1YRZ-R7 and related components, to streamline project resources and eliminate unused assets.
    [adafruit-si5351-breakout.FCStd, black-pcm1802-breakout.FCStd, clock-gen-main-board.kicad_pcb, clock-gen-main-board.kicad_sch]
2026-06-06 Update KiCad project files: corrected project title and version, replaced embedded model paths with environment variable references, and removed obsolete render image to streamline project resources.
    [clock-gen-main-board.kicad_pcb]
2026-06-06 Update KiCad project files: modified project title and version, adjusted component properties, and streamlined pin functions for clarity. Removed obsolete library references and updated netlist handl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
    [clock-gen-main-board.kicad_pcb, clock-gen-main-board.kicad_sch]
2026-06-06 Remove obsolete KiCad project files for the clock generator main board, including DRC, ERC, DRU, PCB, schematic, and project configuration files. Updated the CX Jig project files with new author and 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
    [clock-gen-main-board.kicad_pcb, cxadc-clockgen.kicad_pcb, cxadc-clockgen.kicad_sch, hifi-cx-jig.kicad_sch, main-board.kicad_sch, video-cx-jig.kicad_sch, vt610ex-sc3a-clock-gen-adapter.kicad_pcb]
2026-06-08 refactor: Split combined main board + jig project into discrete ones
    [clockgen-cx-jig.kicad_pcb, clockgen-cx-jig.kicad_sch, clockgen-main-board.kicad_pcb, clockgen-main-board.kicad_sch, cxadc-clockgen.kicad_pcb, cxadc-clockgen.kicad_sch, hifi-cx-jig.kicad_sch, main-board.kicad_sch]
2026-06-08 Add initial fp-lib-table and sym-lib-table for KiCad project
    - Created fp-lib-table with version 7 for footprint libraries.
    - Created sym-lib-table with version 7 for symbol libraries.
    [clockgen-cx-jig.kicad_pcb, clockgen-main-board.kicad_pcb, clockgen-main-board.kicad_sch]
2026-06-09 Add Gerber file for clockgen-cx-jig front silkscreen layer
    [clockgen-cx-jig-B_Cu.gbl, clockgen-cx-jig-B_Mask.gbs, clockgen-cx-jig-B_Paste.gbp, clockgen-cx-jig-B_Silkscreen.gbo, clockgen-cx-jig-Edge_Cuts.gm1, clockgen-cx-jig-F_Cu.gtl, clockgen-cx-jig-F_Mask.gts, clockgen-cx-jig-F_Paste.gtp]
2026-06-11 Update design rules and constraints in KiCad project
    - Changed hole_to_hole check from error to warning.
    - Updated npth_inside_courtyard and pth_inside_courtyard checks to error.
    - Set silk_over_copper and silk_overlap checks to ignore.
    - Adjusted various minimum clearance and connection rules for better compliance.
    - Modified teardrop parameters to reduce curve segment count.
    - Added new track widths and updated via dimensions.
    - Introduced a new design rules file (clockgen-cx-jig.kicad_dru) with custom rules for track width, spacing, silkscreen text, hole diameters, and clearances based on JLCPCB capabilities.
    [clockgen-cx-jig.kicad_pcb, clockgen-main-board.kicad_pcb]
2026-06-12 Add board reference variable to project configuration
    [clockgen-cx-jig.kicad_pcb, clockgen-main-board.kicad_pcb]
