GDH-Technologies/cx-clockgen/(notices)

Notices in the files:
parts and their libraries:
proj-license: CC BY-SA 4.0
